UltraInstinct21/bldc-foc/hardware/bldc_control_final_v6.kicad_pcb

## KiCad design hardware/bldc_control_final_v6.kicad_pcb (2026-11-13)

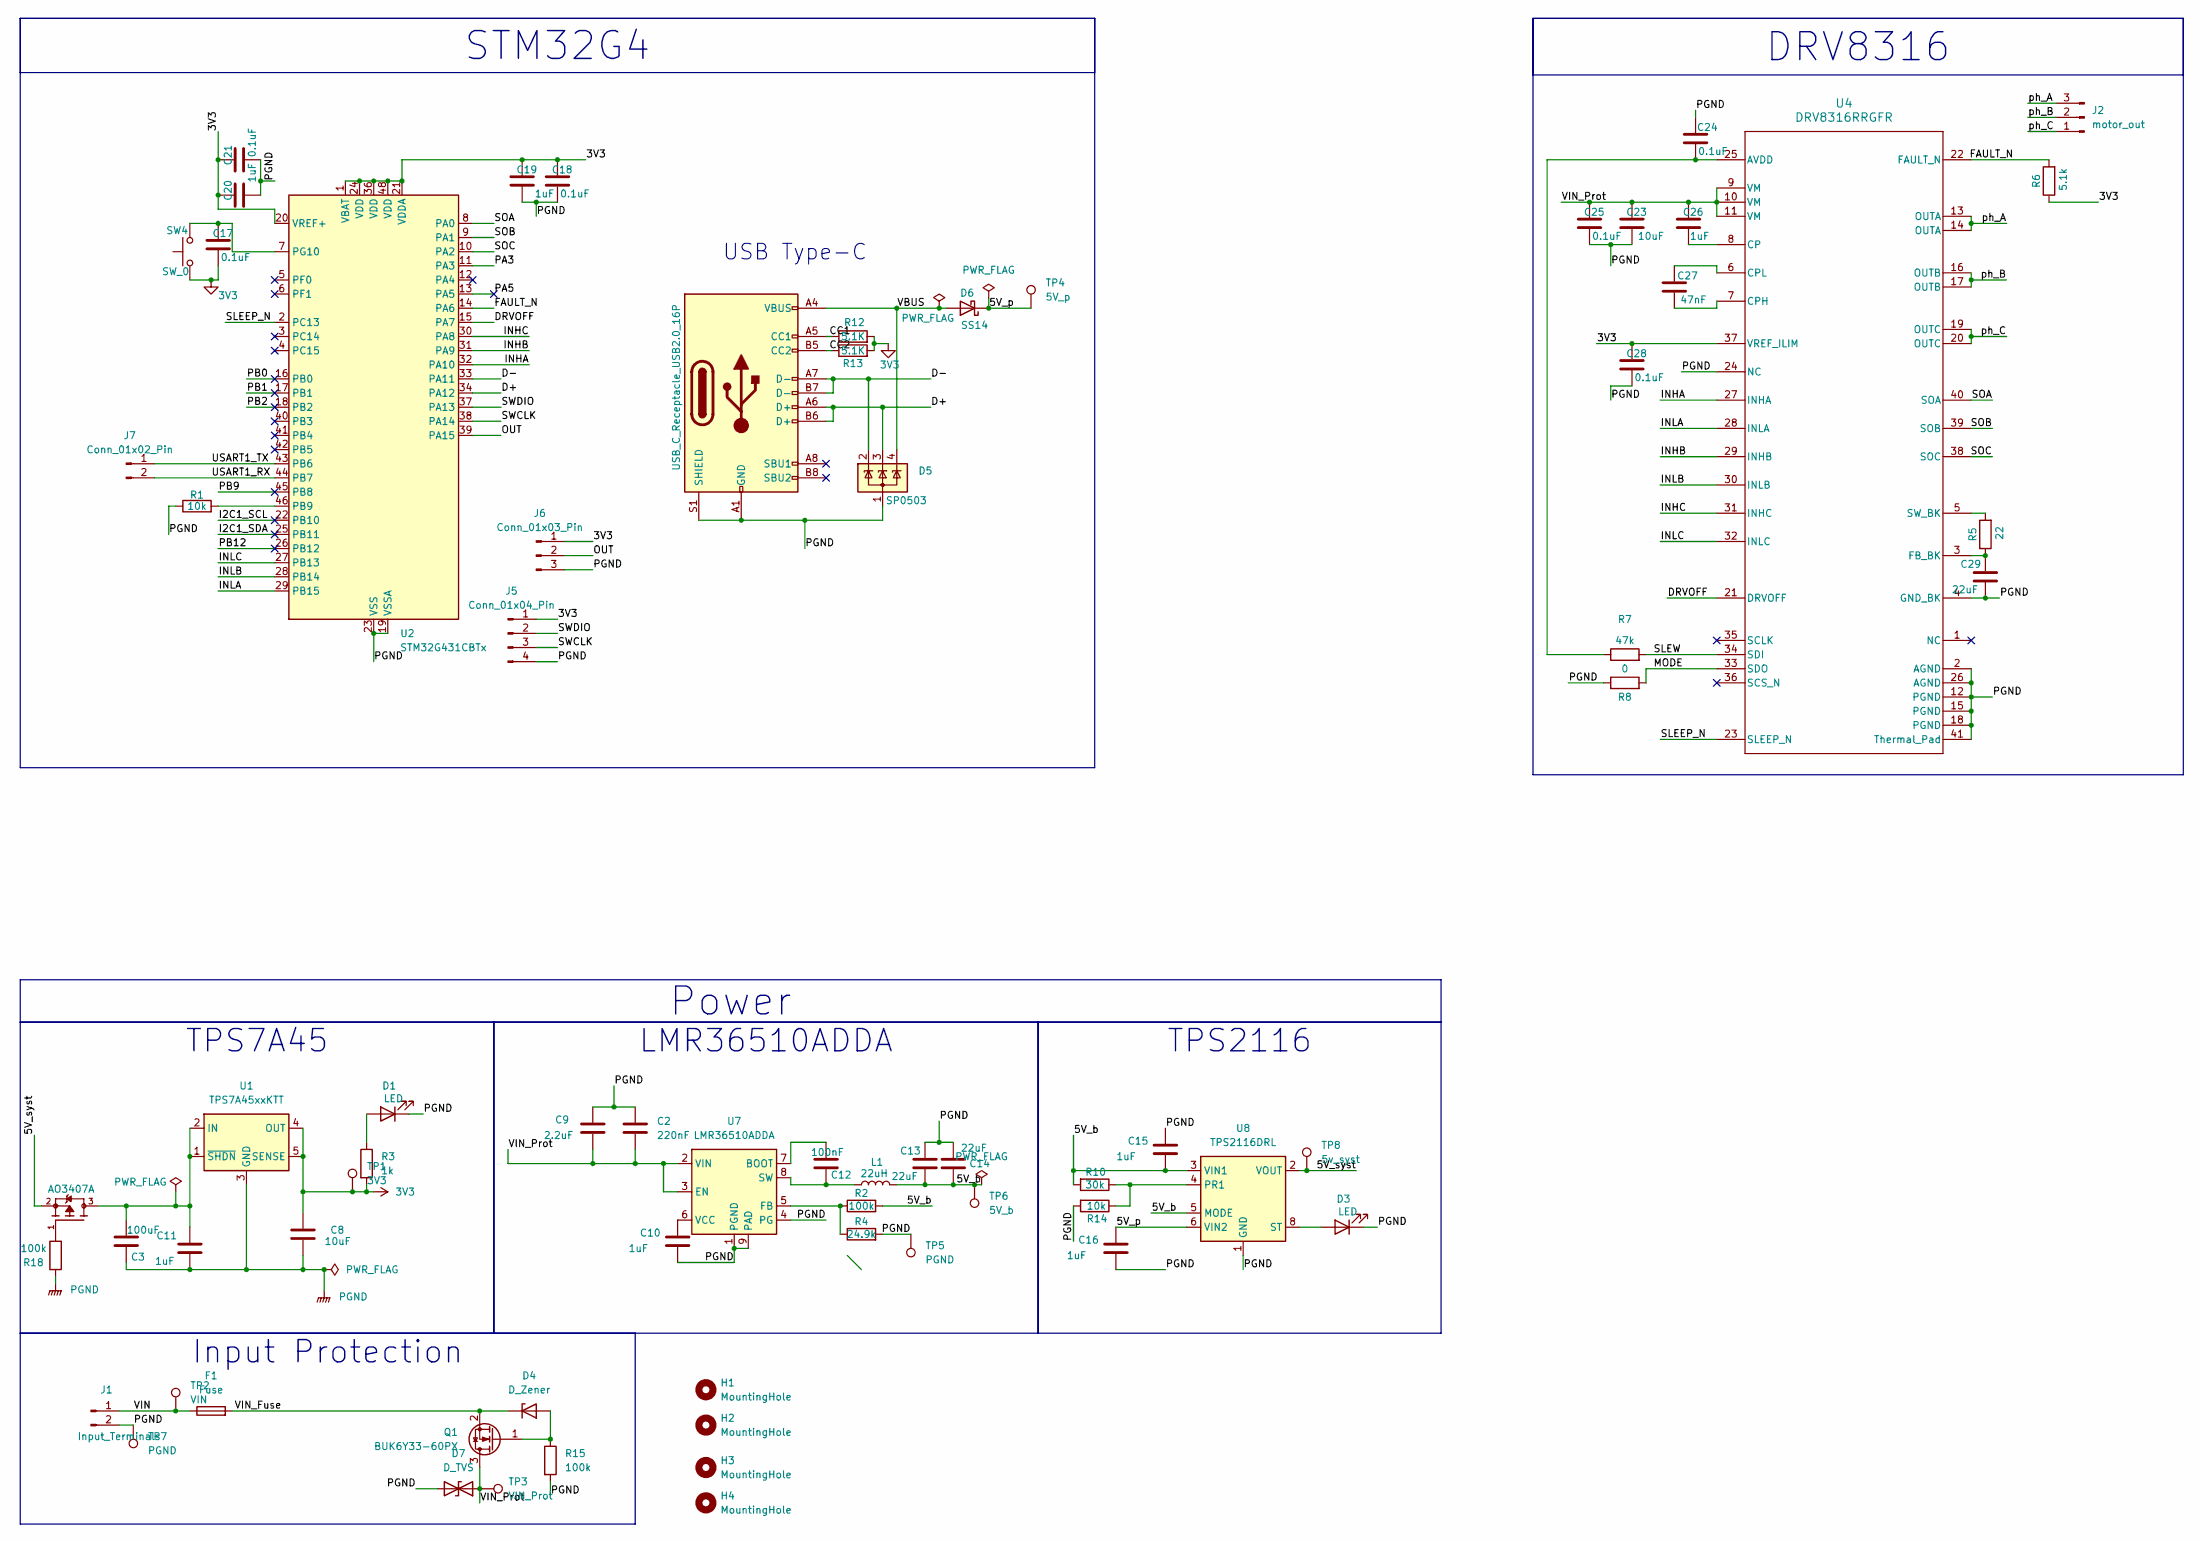
[picture p1: schematic bldc_control_final_v6.kicad_sch]

Parts:
C2: 220nF; C_0805_2012Metric_Pad1.18x1.45mm_HandSolder
C3: 100uF; C_0805_2012Metric_Pad1.18x1.45mm_HandSolder
C8: 10uF; C_0805_2012Metric_Pad1.18x1.45mm_HandSolder
C9: 2.2uF; C_0805_2012Metric_Pad1.18x1.45mm_HandSolder
C10, C11, C15, C16, C19, C20, C26: 1uF; C_0805_2012Metric_Pad1.18x1.45mm_HandSolder
C12: 100nF; C_0805_2012Metric_Pad1.18x1.45mm_HandSolder
C13, C14, C29: 22uF; C_1206_3216Metric_Pad1.33x1.80mm_HandSolder
C17, C18, C21, C24, C25, C28: 0.1uF; C_0805_2012Metric_Pad1.18x1.45mm_HandSolder
C23: 10uF; C_1210_3225Metric_Pad1.33x2.70mm_HandSolder
C27: 47nF; C_0805_2012Metric_Pad1.18x1.45mm_HandSolder
D1, D3: LED; LED_0603_1608Metric
D4: D_Zener; D_SOD-123
D5: SP0503; SOT-143
D6: SS14; D_SMA
D7: D_TVS; D_SMB_Handsoldering
F1: Fuse; Fuse_Bourns_MF-RHT500
H1, H2, H3, H4: MountingHole; MountingHole_2.2mm_M2
J1: Input_Terminals; TerminalBlock_Phoenix_PT-1,5-2-5.0-H_1x02_P5.00mm_Horizontal
J2: motor_out; TerminalBlock_Phoenix_PT-1,5-3-5.0-H_1x03_P5.00mm_Horizontal
J3: USB_C_Receptacle_USB2.0_16P; USB_C_Receptacle_GCT_USB4110
J5: Conn_01x04_Pin; PinHeader_1x04_P2.54mm_Vertical
J6: Conn_01x03_Pin; PinHeader_1x03_P2.54mm_Vertical
J7: Conn_01x02_Pin; PinHeader_1x02_P2.54mm_Vertical
L1: 22uH; L_Bourns-SRN6028
Q1: BUK6Y33-60PX; LFPAK56
Q2: AO3407A; SOT-23; PARTREV 5
R1, R14: 10k; R_0805_2012Metric_Pad1.20x1.40mm_HandSolder
R2, R15, R18: 100k; R_0805_2012Metric_Pad1.20x1.40mm_HandSolder
R3: 1k; R_0805_2012Metric_Pad1.20x1.40mm_HandSolder
R4: 24.9k; R_0805_2012Metric_Pad1.20x1.40mm_HandSolder
R5: 22; R_0805_2012Metric_Pad1.20x1.40mm_HandSolder
R6: 5.1k; R_0805_2012Metric_Pad1.20x1.40mm_HandSolder
R7: 47k; R_0805_2012Metric_Pad1.20x1.40mm_HandSolder
R8: 0; R_0805_2012Metric_Pad1.20x1.40mm_HandSolder
R10: 30k; R_0805_2012Metric_Pad1.20x1.40mm_HandSolder
R12, R13: 5.1K; R_0805_2012Metric_Pad1.20x1.40mm_HandSolder
SW4: SW_0; SW_Push_SPST_NO_Alps_SKRK
TP1: 3V3; TestPoint_Pad_1.5x1.5mm
TP2: VIN; TestPoint_Pad_1.5x1.5mm
TP3: VIN_Prot; TestPoint_Pad_1.5x1.5mm
TP4: 5V_p; TestPoint_Pad_1.5x1.5mm
TP5, TP7: PGND; TestPoint_Pad_1.5x1.5mm
TP6: 5V_b; TestPoint_Pad_1.5x1.5mm
TP8: 5v_syst; TestPoint_Pad_1.5x1.5mm
U1: TPS7A45xxKTT; SOT-223-6_TabPin3
U2: STM32G431CBTx; LQFP-48_7x7mm_P0.5mm
U4: DRV8316RRGFR; RGF0040E-IPC_A
U7: LMR36510ADDA; Texas_HTSOP-8-1EP_3.9x4.9mm_P1.27mm_EP2.95x4.9mm_Mask2.4x3.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
U8: TPS2116DRL; SOT-583-8

Connections:
3V3: C8.1, C17.1, C18.2, C19.2, C20.2, C21.2, C28.2, J5.1, J6.1, R3.2, R6.1, R12.2, R13.2, SW4.1, TP1.1 (1_1), U1.4 (OUT), U1.5 (SENSE), U2.1 (VBAT), U2.20 (VREF+), U2.21 (VDDA), U2.24 (VDD), U2.36 (VDD), U2.48 (VDD), U4.37 (VREF_ILIM); also elsewhere on the board
/5V_b: C13.2, C14.2, C15.2, L1.2, R2.2, R10.2, TP6.1 (1_1), U8.3 (VIN1), U8.5 (MODE); also elsewhere on the board
/5V_p: C16.1, D6.1 (K), TP4.1 (1_1), U8.6 (VIN2); also elsewhere on the board
/5V_syst: Q2.2, TP8.1 (1_1), U8.2 (VOUT), U8.7 (VOUT); also elsewhere on the board
/CC1: J3.A5 (CC1), R12.1
/CC2: J3.B5 (CC2), R13.1
/D+: D5.3 (K), J3.A6 (D+), J3.B6 (D+), U2.34 (PA12); also elsewhere on the board
/D-: D5.2 (K), J3.A7 (D-), J3.B7 (D-), U2.33 (PA11); also elsewhere on the board
/FAULT_N: R6.2, U2.14 (PA6), U4.22 (FAULT_N); also elsewhere on the board
/MODE: R8.2, U4.33 (SDO); also elsewhere on the board
/OUT: J6.2, U2.39 (PA15); also elsewhere on the board
/SLEW: R7.2, U4.34 (SDI); also elsewhere on the board
/SWCLK: J5.3, U2.38 (PA14); also elsewhere on the board
/SWDIO: J5.2, U2.37 (PA13); also elsewhere on the board
/USART1_RX: J7.2, U2.44 (PB7); also elsewhere on the board
/USART1_TX: J7.1, U2.43 (PB6); also elsewhere on the board
/VBUS: D5.4 (K), D6.2 (A), J3.A4 (VBUS), J3.A9 (VBUS), J3.B4 (VBUS), J3.B9 (VBUS)
/VIN: F1.1, J1.1, TP2.1 (1_1)
/VIN_Fuse: D4.1 (K), F1.2, Q1.2 (S)
/VIN_Prot: C2.2, C9.2, C23.2, C25.2, C26.2, D7.1 (A1), Q1.3 (D), TP3.1 (1_1), U4.9 (VM), U4.10 (VM), U4.11 (VM), U7.2 (VIN), U7.3 (EN); also elsewhere on the board
/ph_A: J2.3, U4.13 (OUTA), U4.14 (OUTA); also elsewhere on the board
/ph_B: J2.2, U4.16 (OUTB), U4.17 (OUTB); also elsewhere on the board
/ph_C: J2.1, U4.19 (OUTC), U4.20 (OUTC); also elsewhere on the board
unnamed: D1.2 (A), R3.1
unnamed 44: D3.2 (A), U8.8 (ST); also elsewhere on the board
unnamed: D4.2 (A), Q1.1 (G), R15.1
unnamed: Q2.1, R18.2
unnamed 47: C3.1, C11.1, Q2.3, U1.1 (~SHDN), U1.2 (IN); also elsewhere on the board
unnamed 48: R1.2, U2.46 (PB9); also elsewhere on the board
unnamed 49: C17.2, SW4.2, U2.7 (PG10); also elsewhere on the board
unnamed: U2.2 (PC13), U4.23 (SLEEP_N)
unnamed: U2.8 (PA0), U4.40 (SOA)
unnamed: U2.9 (PA1), U4.39 (SOB)
unnamed: U2.10 (PA2), U4.38 (SOC)
unnamed: U2.15 (PA7), U4.21 (DRVOFF)
unnamed: U2.27 (PB13), U4.32 (INLC)
unnamed: U2.28 (PB14), U4.30 (INLB)
unnamed: U2.29 (PB15), U4.28 (INLA)
unnamed: U2.30 (PA8), U4.31 (INHC)
unnamed: U2.31 (PA9), U4.29 (INHB)
unnamed: U2.32 (PA10), U4.27 (INHA)
unnamed 61: C24.1, R7.1, U4.25 (AVDD); also elsewhere on the board
unnamed 62: C26.1, U4.8 (CP); also elsewhere on the board
unnamed 63: C27.1, U4.7 (CPH); also elsewhere on the board
unnamed 64: C27.2, U4.6 (CPL); also elsewhere on the board
unnamed 65: C29.1, R5.1, U4.3 (FB_BK); also elsewhere on the board
unnamed 66: R5.2, U4.5 (SW_BK); also elsewhere on the board
unnamed 67: C12.1, U7.7 (BOOT); also elsewhere on the board
unnamed 68: R2.1, R4.1, U7.5 (FB); also elsewhere on the board
unnamed 69: C12.2, L1.1, U7.8 (SW); also elsewhere on the board
unnamed 70: C10.1, U7.6 (VCC); also elsewhere on the board
unnamed 71: R10.1, R14.1, U8.4 (PR1); also elsewhere on the board
PGND: C2.1, C3.2, C8.2, C9.1, C10.2, C11.2, C13.1, C14.1, C15.1, C16.2, C18.1, C19.1, C20.1, C21.1, C23.1, C24.2, C25.1, C28.1, C29.2, D1.1 (K), D3.1 (K), D5.1 (A), D7.2 (A2), J1.2, J3.A1 (GND), J3.A12 (GND), J3.B1 (GND), J3.B12 (GND), J3.S1 (SHIELD), J5.4, J6.3, R1.1, R4.2, R8.1, R14.2, R15.2, R18.1, TP5.1 (1_1), TP7.1 (1_1), U1.3 (GND), U2.19 (VSSA), U2.23 (VSS), U2.35 (VSS), U2.47 (VSS), U4.2 (AGND), U4.4 (GND_BK), U4.12 (PGND), U4.15 (PGND), U4.18 (PGND), U4.24 (NC), U4.26 (AGND), U4.41 (Thermal_Pad), U7.1 (PGND), U7.4 (PG), U7.9 (PAD), U8.1 (GND); also elsewhere on the board

Notes on the sheet:
USB Type-C
LMR36510ADDA
TPS7A45
TPS2116
Power
DRV8316
STM32G4
Input Protection

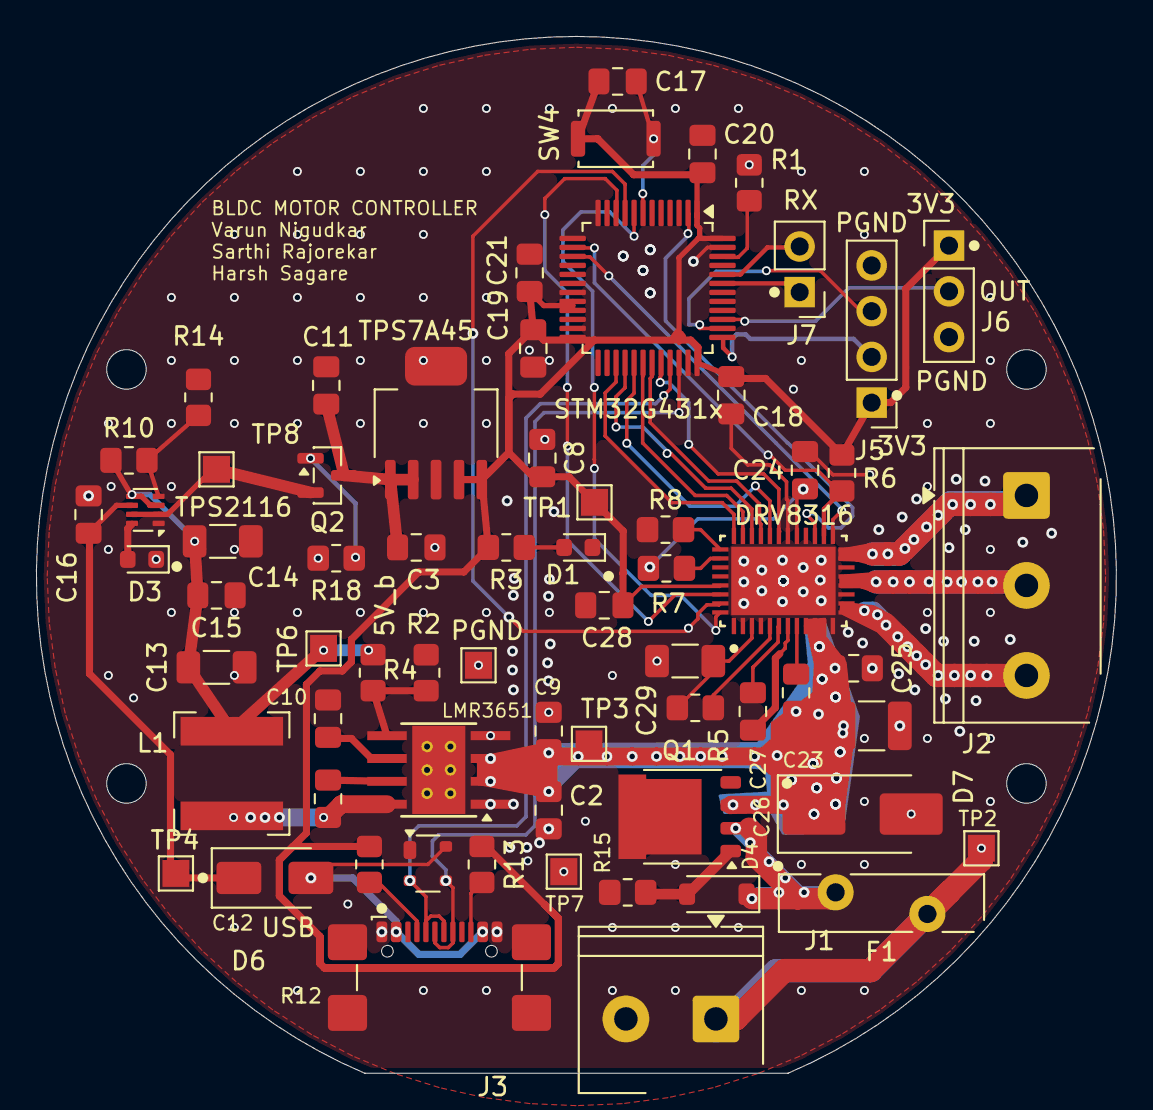
[picture p2: board bldc_control_final_v6.kicad_pcb from above]

Board: 2 copper layers, 60.0 x 57.6 mm, 71 parts (0 on the bottom side), 53 nets.

Other parts of the board:
DRV8316: DRV8316RRGFR; RGF0040E-IPC_A
LMR3651: LMR36510ADDA; Texas_HTSOP-8-1EP_3.9x4.9mm_P1.27mm_EP2.95x4.9mm_Mask2.4x3.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
STM32G431x: STM32G431CBTx; LQFP-48_7x7mm_P0.5mm
TPS7A45: TPS7A45xxKTT; SOT-223-6_TabPin3
TPS2116: TPS2116DRL; SOT-583-8

Their connections:
3V3: DRV8316.37 (VREF_ILIM), STM32G431x.1 (VBAT), STM32G431x.20 (VREF+), STM32G431x.21 (VDDA), STM32G431x.24 (VDD), STM32G431x.36 (VDD), STM32G431x.48 (VDD), TPS7A45.4 (OUT), TPS7A45.5 (SENSE); also elsewhere on the board
/5V_b: TPS2116.3 (VIN1), TPS2116.5 (MODE); also elsewhere on the board
/5V_p: TPS2116.6 (VIN2); also elsewhere on the board
/5V_syst: TPS2116.2 (VOUT), TPS2116.7 (VOUT); also elsewhere on the board
/D+: STM32G431x.34 (PA12); also elsewhere on the board
/D-: STM32G431x.33 (PA11); also elsewhere on the board
/DRVOFF: DRV8316.21 (DRVOFF), STM32G431x.15 (PA7)
/FAULT_N: DRV8316.22 (FAULT_N), STM32G431x.14 (PA6); also elsewhere on the board
/INHA: DRV8316.27 (INHA), STM32G431x.32 (PA10)
/INHB: DRV8316.29 (INHB), STM32G431x.31 (PA9)
/INHC: DRV8316.31 (INHC), STM32G431x.30 (PA8)
/INLA: DRV8316.28 (INLA), STM32G431x.29 (PB15)
/INLB: DRV8316.30 (INLB), STM32G431x.28 (PB14)
/INLC: DRV8316.32 (INLC), STM32G431x.27 (PB13)
/MODE: DRV8316.33 (SDO); also elsewhere on the board
/OUT: STM32G431x.39 (PA15); also elsewhere on the board
/SLEEP_N: DRV8316.23 (SLEEP_N), STM32G431x.2 (PC13)
/SLEW: DRV8316.34 (SDI); also elsewhere on the board
/SOA: DRV8316.40 (SOA), STM32G431x.8 (PA0)
/SOB: DRV8316.39 (SOB), STM32G431x.9 (PA1)
/SOC: DRV8316.38 (SOC), STM32G431x.10 (PA2)
/SWCLK: STM32G431x.38 (PA14); also elsewhere on the board
/SWDIO: STM32G431x.37 (PA13); also elsewhere on the board
/USART1_RX: STM32G431x.44 (PB7); also elsewhere on the board
/USART1_TX: STM32G431x.43 (PB6); also elsewhere on the board
/VIN_Prot: DRV8316.9 (VM), DRV8316.10 (VM), DRV8316.11 (VM), LMR3651.2 (VIN), LMR3651.3 (EN); also elsewhere on the board
/ph_A: DRV8316.13 (OUTA), DRV8316.14 (OUTA); also elsewhere on the board
/ph_B: DRV8316.16 (OUTB), DRV8316.17 (OUTB); also elsewhere on the board
/ph_C: DRV8316.19 (OUTC), DRV8316.20 (OUTC); also elsewhere on the board
unnamed 44: TPS2116.8 (ST); also elsewhere on the board
unnamed 47: TPS7A45.1 (~SHDN), TPS7A45.2 (IN); also elsewhere on the board
unnamed 48: STM32G431x.46 (PB9); also elsewhere on the board
unnamed 49: STM32G431x.7 (PG10); also elsewhere on the board
unnamed 61: DRV8316.25 (AVDD); also elsewhere on the board
unnamed 62: DRV8316.8 (CP); also elsewhere on the board
unnamed 63: DRV8316.7 (CPH); also elsewhere on the board
unnamed 64: DRV8316.6 (CPL); also elsewhere on the board
unnamed 65: DRV8316.3 (FB_BK); also elsewhere on the board
unnamed 66: DRV8316.5 (SW_BK); also elsewhere on the board
unnamed 67: LMR3651.7 (BOOT); also elsewhere on the board
unnamed 68: LMR3651.5 (FB); also elsewhere on the board
unnamed 69: LMR3651.8 (SW); also elsewhere on the board
unnamed 70: LMR3651.6 (VCC); also elsewhere on the board
unnamed 71: TPS2116.4 (PR1); also elsewhere on the board
PGND: DRV8316.2 (AGND), DRV8316.4 (GND_BK), DRV8316.12 (PGND), DRV8316.15 (PGND), DRV8316.18 (PGND), DRV8316.24 (NC), DRV8316.26 (AGND), DRV8316.41 (Thermal_Pad), LMR3651.1 (PGND), LMR3651.4 (PG), LMR3651.9 (PAD), STM32G431x.19 (VSSA), STM32G431x.23 (VSS), STM32G431x.35 (VSS), STM32G431x.47 (VSS), TPS7A45.3 (GND), TPS2116.1 (GND); also elsewhere on the board
