UltraInstinct21/bldc-foc/(commit log)

2026-11-13 Initial commit: sensored FOC firmware and board tests
    [bldc_control_final_v6.kicad_pcb, bldc_control_final_v6.kicad_sch]
2026-11-13 Add ESP32 WiFi bridge integration, DRV8316CT hardware mode, and updated board files
    - Add firmware/foc_esp with half-duplex USART1 link and dual watchdogs
    - Add firmware/tests/test_07_esp_link for UART link verification
    - Add esp32/bldc_bridge Arduino sketch with embedded responsive web dashboard
    - Add docs/esp32.md reference covering research, timing, protocol, and wiring
    - Migrate firmware from DRV8316R SPI to DRV8316CT hardware straps (0.3 V/A CSA)
    - Replace test_02_drv8316_spi with test_02_drv8316
    - Update hardware files from bldc_control_final_zip and rewrite hardware/README.md
    [bldc_control_final_v6.kicad_pcb, bldc_control_final_v6.kicad_sch]
2026-11-13 docs: sync hardware.md and bringup.md with v6 board verification and DRV8316CT
2026-11-13 fix(firmware): align current clamp to 4.0A, add I2C bus auto-recovery, and resolve half-duplex UART contention
    [as5600.c, as5600.h, bldc_bridge.ino, foc.c, foc.h, main.c]
2026-11-13 docs(tests): remove legacy SPI mentions from test_05 and test_06
2026-11-13 refactor(firmware): ponytail cleanup of over-engineering
    - Remove unused HAL_SPI_MODULE_ENABLED and prune CubeMX boilerplate in stm32g4xx_hal_conf.h
    - Remove 176-line syscalls.c; provide lean POSIX stubs in board.c
    - Fold 88-line drv8316 abstraction layer directly into board.c/board.h
    - Replace custom DBG_Printf stack buffer with direct stdio retargeting via _write
    - Remove redundant CubeMX main.h
    - Net reduction: 613 lines across 21 files; all 10 apps build with zero warnings
    [board.c, board.h, foc.h, main.c]
